Markell/USonicRoboCar/README.md

# USonicRoboCar
Ultrasonic abstacle avoiding arduino robot
