Markell/USonicRoboCar/img/a4.jpg

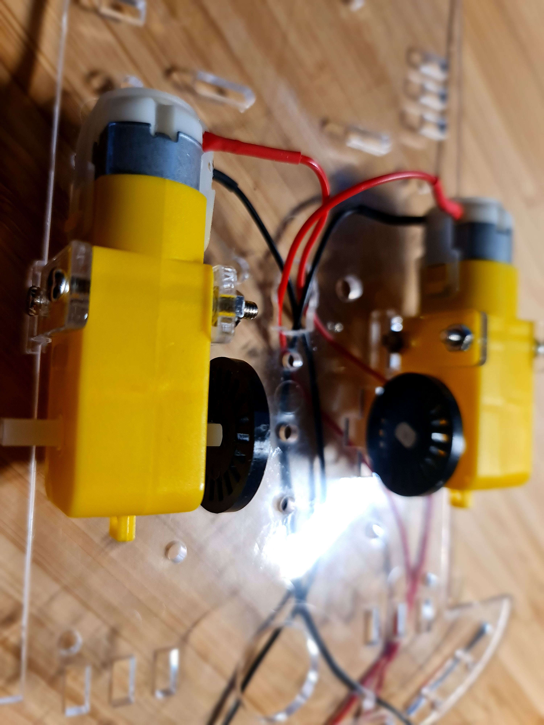
img/a4.jpg
