Markell/USonicRoboCar/img/a6.jpg

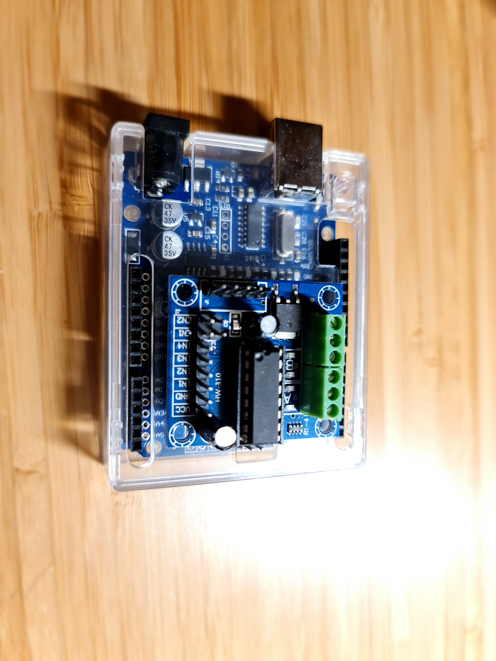
img/a6.jpg
